amckay1/KilliFeeder/README.md

# KilliFeeder

## Components
1) Hardware
2) Software
3) Julia package: https://github.com/amckay1/Killifeeder.jl
