amckay1/KilliFeeder/Hardware/LaserCut/LaserCut.dxf

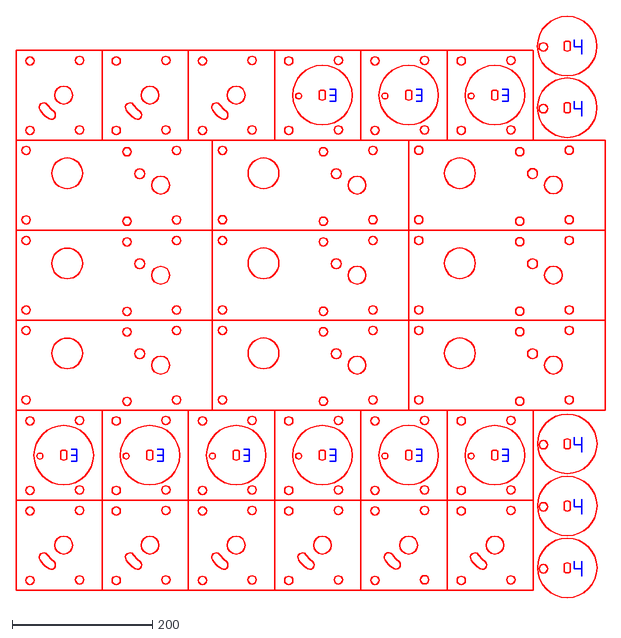
[picture p1: CAD file, 2020-06-01]
Hardware/LaserCut/LaserCut.dxf
841.2 x 830.3
