amckay1/KilliFeeder/Hardware/Print3D/stl/bottom.stl

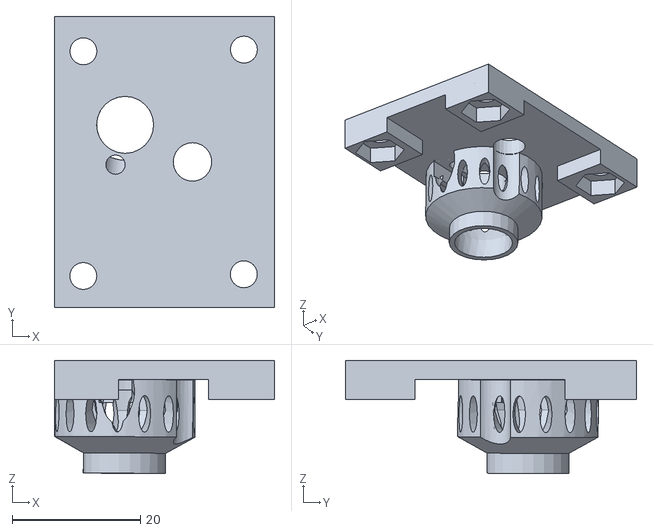
[picture p2: CAD file, 2020-06-01]
Hardware/Print3D/stl/bottom.stl
34.3 x 45.3 x 17.6
