amckay1/KilliFeeder/Hardware/Print3D/stl/backstop.stl

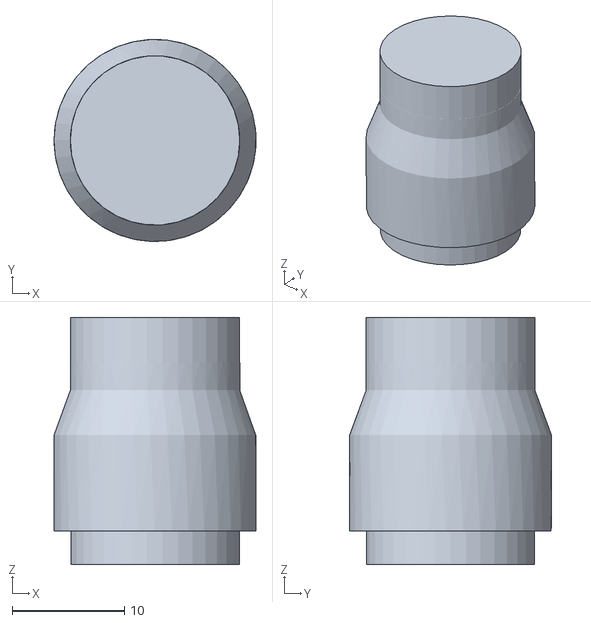
[picture p3: CAD file, 2020-06-01]
Hardware/Print3D/stl/backstop.stl
18.0 x 18.0 x 22.0
