amckay1/KilliFeeder/Hardware/Print3D/stl/top.stl

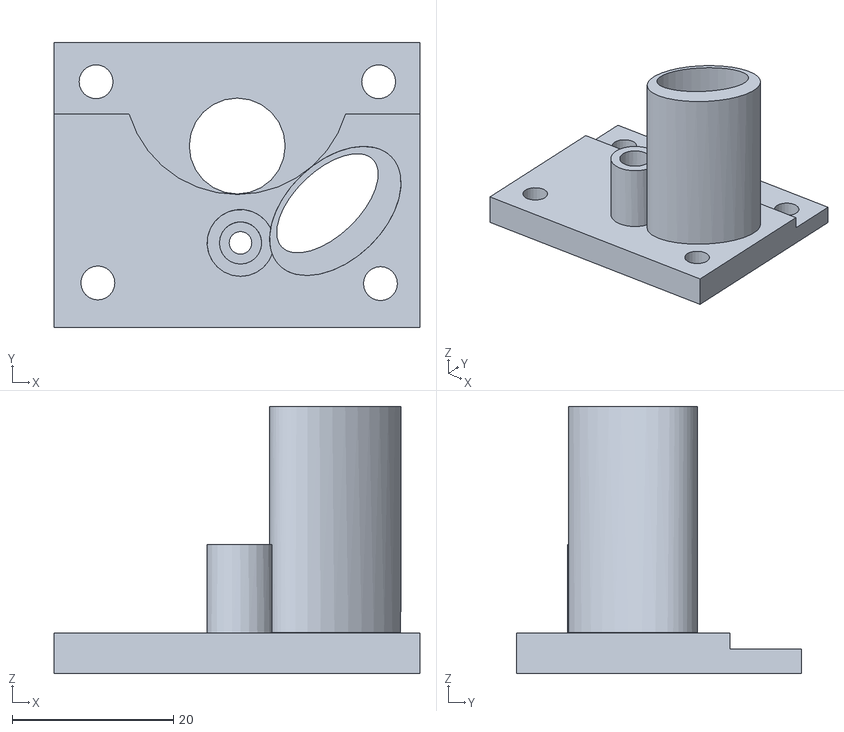
[picture p4: CAD file, 2020-06-01]
Hardware/Print3D/stl/top.stl
45.3 x 35.3 x 33.1
