amckay1/KilliFeeder/(list of files, cad)

Other CAD files:
Hardware/Print3D/AutoCad_dwg/top_bottom.dwg
Hardware/Print3D/AutoCad_dwg/backstop.dwg
Hardware/LaserCut/LaserCut.dwg
