amckay1/KilliFeeder/Hardware/PCB/WemosD1_Feeder.brd

## EAGLE design Hardware/PCB/WemosD1_Feeder.brd (2020-06-01)

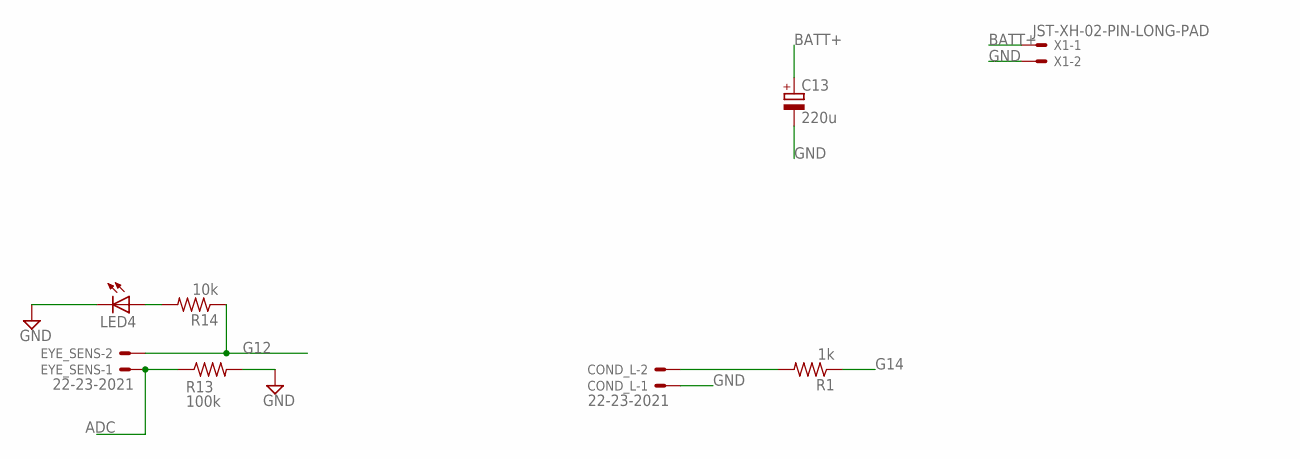
[picture p5: schematic WemosD1_Feeder.sch, sheet 1]

Parts:
C13: 220u; E2,5-7
COND_L: 22-23-2021
EYE_SENS: 22-23-2021
LED4: LED5MM
R1: 1k; R0603
R13: 100k; R0603
R14: 10k; R0603
X1: JST-XH-02-PIN-LONG-PAD; JST-XH-02-PACKAGE-LONG-PAD

Connections:
ADC: EYE_SENS.1, R13.1; also elsewhere on the board
BATT+: C13.+, X1.1; also elsewhere on the board
G12: EYE_SENS.2, R14.1; also elsewhere on the board
G14: R1.1; also elsewhere on the board
GND: C13.-, COND_L.1, LED4.K (C), R13.2, X1.2; also elsewhere on the board
unnamed: COND_L.2, R1.2
unnamed: LED4.A, R14.2

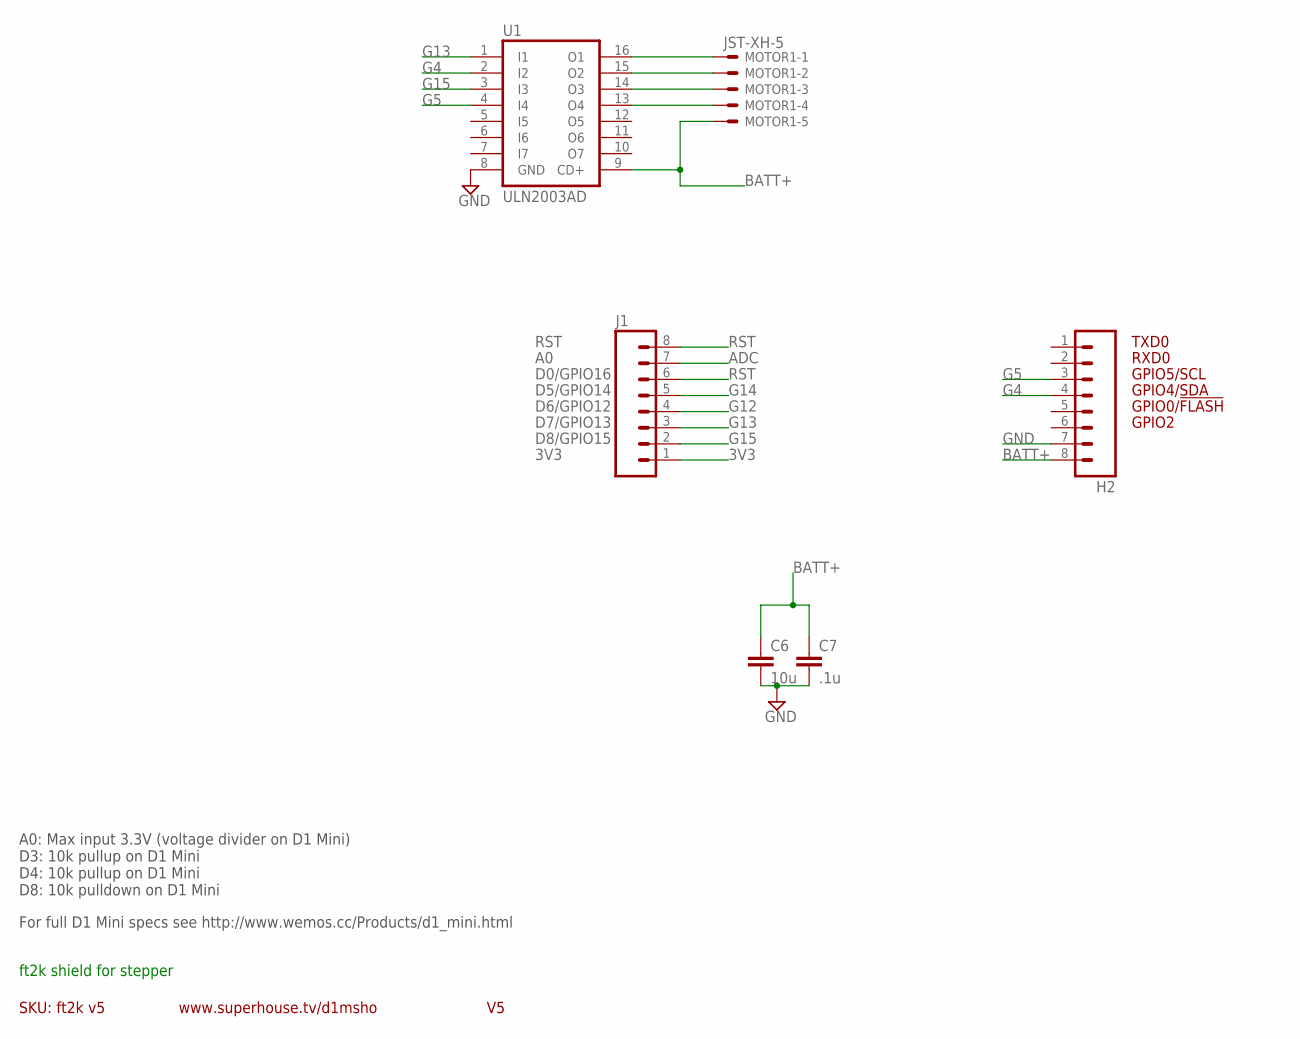
[picture p6: schematic WemosD1_Feeder.sch, sheet 2]

Parts:
C6: 10u; C0603
C7: .1u; C0603
H2: M08; 1X08
J1: M08; 1X08_ROUND
MOTOR1: JST-XH-5; JST-XH-5P
U1: ULN2003AD; SO16

Connections:
3V3: J1.1
ADC: J1.7; also elsewhere on the board
BATT+: C6.1, C7.1, H2.8, MOTOR1.P$5, U1.9 (CD+); also elsewhere on the board
G4: H2.4, U1.2 (I2)
G5: H2.3, U1.4 (I4)
G12: J1.4; also elsewhere on the board
G13: J1.3, U1.1 (I1)
G14: J1.5; also elsewhere on the board
G15: J1.2, U1.3 (I3)
GND: C6.2, C7.2, H2.7, U1.8 (GND); also elsewhere on the board
unnamed: MOTOR1.P$1, U1.16 (O1)
unnamed: MOTOR1.P$2, U1.15 (O2)
unnamed: MOTOR1.P$3, U1.14 (O3)
unnamed: MOTOR1.P$4, U1.13 (O4)
RST: J1.6, J1.8

Notes on the sheet:
GPIO2
GPIO0/!FLASH
GPIO4/SDA
GPIO5/SCL
RXD0
TXD0
SKU: ft2k v5
www.superhouse.tv/d1msho
A0: Max input 3.3V (voltage divider on D1 Mini) D3: 10k pullup on D1 Mini D4: 10k pullup on D1 Mini D8: 10k pulldown on D1 Mini
For full D1 Mini specs see http://www.wemos.cc/Products/d1_mini.html
ft2k shield for stepper
RST
D0/GPIO16
D5/GPIO14
D6/GPIO12
D7/GPIO13
D8/GPIO15
3V3

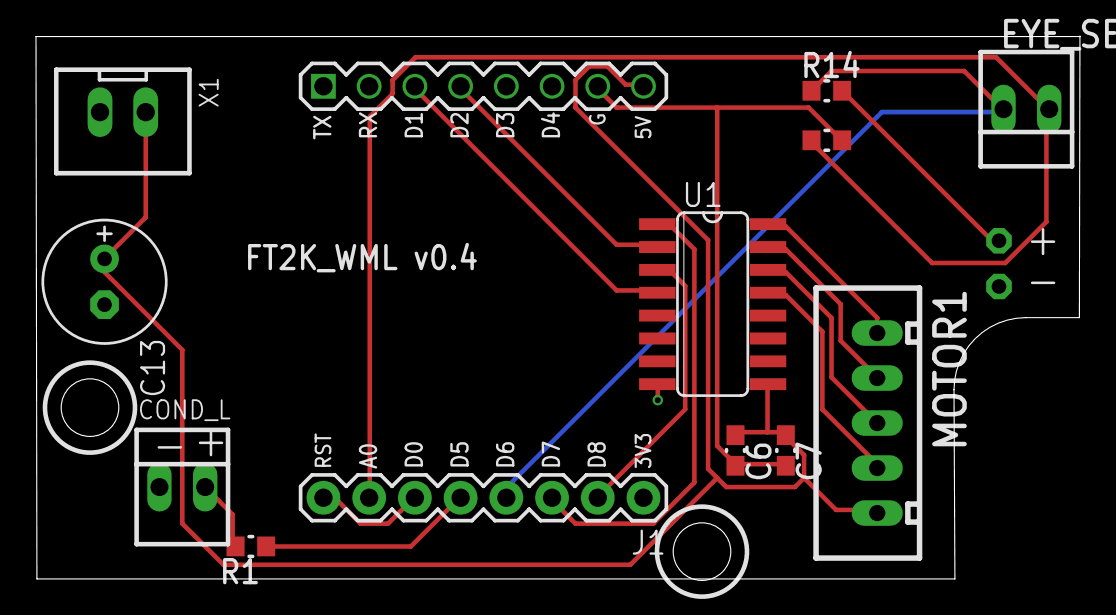
[picture p7: board WemosD1_Feeder.brd from above]

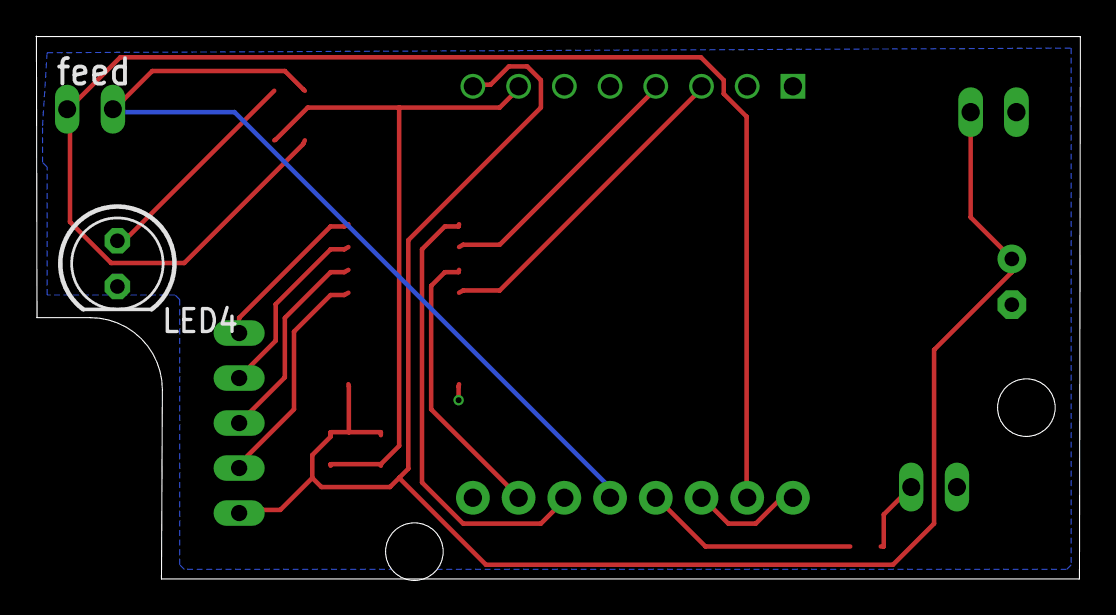
[picture p8: board WemosD1_Feeder.brd from below]

Board: 2 copper layers, 58.0 x 30.2 mm, 15 parts (2 on the bottom side), 16 nets.

Other parts of the board:
U$3: FT2K_PLATE
