amckay1/KilliFeeder/Software/RemoteServer/archive/setupvpn.md

https://medium.freecodecamp.org/running-your-own-openvpn-server-on-a-raspberry-pi-8b78043ccdea

setting up on aws 52.24.161.106, then going to only allow 8500 from that IP address.
