amckay1/KilliFeeder/(notices)

Notices in the files:
parts and their libraries:
freetronics-original: Licensing: CC v3.0 Share-Alike You are welcome to use this library for commercial purposes.
SparkFun-Connectors: Licensing: Creative Commons ShareAlike 4.0 International - https://creativecommons.org/licenses/by-sa/4.0
